GLMiranda0/Coletor-eixo/pcb/fabricacao/BOM_Coletor-Eixo_v0.2.csv

No. | Quantity | Comment | Designator | Footprint | Value | Manufacturer Part | Manufacturer | Supplier Part | Supplier
1 | 2 | 22uF | C1,C2 | C0805 | 22uF | CL21A226MAQNNNE | SAMSUNG(三星) | C45783 | LCSC
2 | 6 | 100nF | C3,C5,C7,C12,C16,C17 | C0603 | 100nF | CC0603KRX7R9BB104 | YAGEO(国巨) | C14663 | LCSC
3 | 5 | 10uF | C4,C8,C13,C14,C15 | C0603 | 10uF | CL10A106KP8NNNC | SAMSUNG(三星) | C19702 | LCSC
4 | 1 | 1uF | C6 | C0603 | 1uF | CL10A105KB8NNNC | SAMSUNG(三星) | C15849 | LCSC
5 | 3 | 10nF | C9,C10,C11 | C0603 | 10nF | 0603B103K500NT | FH(风华) | C57112 | LCSC
6 | 1 | SS14 | D1 | SMA_L4.2-W2.6-LS5.0-RD_1 |  | SS14 | MDD(辰达半导体) | C2480 | LCSC
7 | 1 | BSMD1206-050-16V | F1 | F1206 |  | BSMD1206-050-16V | BHFUSE(佰宏) | C883124 | LCSC
8 | 1 | TYPE-C 16PIN 2MD(073) | J1 | USB-C-SMD_TYPE-C-16PIN-2MD-073 |  | TYPE-C 16PIN 2MD(073) | SHOU HAN(首韩) | C2765186 | LCSC
9 | 3 | PJ-3240-5A | J2,J3,J4 | AUDIO-TH_PJ-3240-5A |  | PJ-3240-5A | 韩国韩荣 | C145814 | LCSC
10 | 1 | KF2EDGR-3.81-5P | J5 | CONN-TH_5P-P3.81_KF2EDGR-3.81-5P |  | KF2EDGR-3.81-5P | KEFA(科发) | C441185 | LCSC
11 | 1 | B2B-PH-K-S(LF)(SN) | J6 | CONN-TH_B2B-PH-K-S |  | B2B-PH-K-S(LF)(SN) | JST | C131337 | LCSC
12 | 1 | 19-217/BHC-ZL1M2RY/3T | LED1 | LED0603-FD_BLUE |  | 19-217/BHC-ZL1M2RY/3T | EVERLIGHT(亿光) | C72041 | LCSC
13 | 1 | KT-0603R | LED2 | LED-SMD_L1.6-W0.8-R-RD |  | KT-0603R | KENTO | C2286 | LCSC
14 | 1 | 19-217/GHC-YR1S2/3T | LED3 | LED0603-RD |  | 19-217/GHC-YR1S2/3T | EVERLIGHT(亿光) | C72043 | LCSC
15 | 2 | MMBT3904(RANGE:100-300) | Q1,Q2 | SOT-23-3_L2.9-W1.3-P1.90-LS2.4-BR |  | MMBT3904(RANGE:100-300) | CJ(江苏长电/长晶) | C20526 | LCSC
16 | 1 | AO3401A | Q3 | SOT-23_L2.9-W1.3-P1.90-LS2.4-BR |  | AO3401A | AOS | C15127 | LCSC
17 | 2 | 5.1kΩ | R1,R2 | R0603 | 5.1kΩ | 0603WAF5101T5E | UNI-ROYAL(厚声) | C23186 | LCSC
18 | 6 | 10kΩ | R3,R4,R5,R6,R8,R9 | R0603 | 10kΩ | 0603WAF1002T5E | UNI-ROYAL(厚声) | C25804 | LCSC
19 | 7 | 1kΩ | R7,R10,R11,R12,R17,R19,R20 | R0603 | 1kΩ | 0603WAF1001T5E | UNI-ROYAL(厚声) | C21190 | LCSC
20 | 3 | 4.7kΩ | R13,R14,R15 | R0603 | 4.7kΩ | 0603WAF4701T5E | UNI-ROYAL(厚声) | C23162 | LCSC
21 | 1 | 100Ω | R16 | R0603 | 100Ω | 0603WAF1000T5E | UNI-ROYAL(厚声) | C22775 | LCSC
22 | 1 | 2.4kΩ | R18 | R0603 | 2.4kΩ | 0603WAF2401T5E | UNI-ROYAL(厚声) | C22940 | LCSC
23 | 3 | 100kΩ | R21,R22,R24 | R0603 | 100kΩ | 0603WAF1003T5E | UNI-ROYAL(厚声) | C25803 | LCSC
24 | 1 | 68kΩ | R23 | R0603 | 68kΩ | 0603WAF6802T5E | UNI-ROYAL(厚声) | C23231 | LCSC
25 | 2 | TS-1187A-B-A-B | SW1,SW2 | SW-SMD_4P-L5.1-W5.1-P3.70-LS6.5-TL_H1.5 |  | TS-1187A-B-A-B | XKB Connection(中国星坤) | C318884 | LCSC
26 | 1 | MSK12C02 | SW3 | SW-TH_MSK12C02 |  | MSK12C02 | SHOU HAN(首韩) | C431540 | LCSC
27 | 1 | 2.4GHz | U1 | WIFI-SMD_ESP32-WROOM-32E | 2.4GHz | ESP32-WROOM-32E-N4 | ESPRESSIF(乐鑫) | C701341 | LCSC
28 | 1 | CH340C | U2 | SOP-16_L10.0-W3.9-P1.27-LS6.0-BL |  | CH340C | WCH(南京沁恒) | C84681 | LCSC
29 | 1 | AP2112K-3.3TRG1 | U3 | SOT-25-5_L2.9-W1.6-P0.95-LS2.8-BL |  | AP2112K-3.3TRG1 | DIODES(美台) | C51118 | LCSC
30 | 1 | USBLC6-2SC6 | U4 | SOT-23-6_L2.9-W1.6-P0.95-LS2.8-BL |  | USBLC6-2SC6 | ST(意法半导体) | C7519 | LCSC
31 | 1 | DW01A | U5 | SOT-23-6_L2.9-W1.6-P0.95-LS2.8-BL |  | DW01A | PUOLOP(迪浦) | C351410 | LCSC
32 | 1 | FS8205 | U6 | SOT-23-6_L2.9-W1.6-P0.95-LS2.8-BR |  | FS8205 | FORTUNE(富晶) | C32254 | LCSC
33 | 1 | TP4056-42-ESOP8 | U7 | ESOP-8_L4.9-W3.9-P1.27-LS6.0-BL-EP |  | TP4056-42-ESOP8 | TOPPOWER(南京拓微) | C16581 | LCSC
