GLMiranda0/Coletor-eixo/case/out/principal/unidade_principal_montagem.step

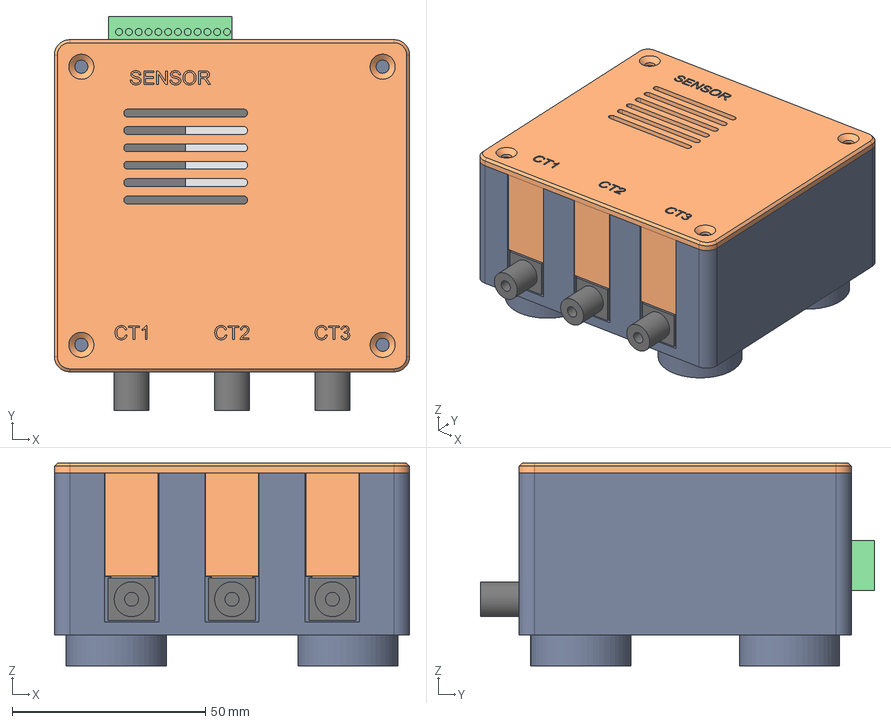
[picture p3: CAD file, 2026-11-05, last stored version]
case/out/principal/unidade_principal_montagem.step
92.0 x 102.0 x 52.5 mm
caixa_0
tampa_1
presilha_1_2
presilha_2_3
ima_4
ima_5
ima_6
ima_7
protoboard_8
esp32_pcb_9
esp32_modulo_10
usb_c_11
borneira_principal_12
p2_adaptador_13
p2_borne_14
p2_adaptador_15
p2_borne_16
p2_adaptador_17
p2_borne_18
