GLMiranda0/Coletor-eixo/case/out/sensor/base_metalica.step

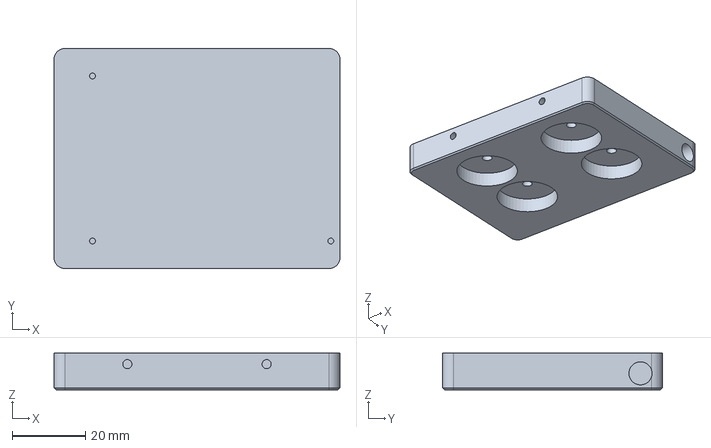
[picture p4: CAD file, 2026-11-05, last stored version]
case/out/sensor/base_metalica.step
78.0 x 60.0 x 10.0 mm
