GLMiranda0/Coletor-eixo/case/out/principal/caixa.stl

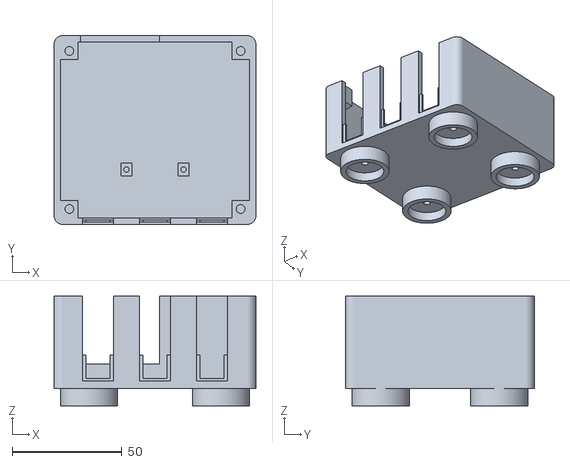
[picture p5: CAD file, 2026-11-05, last stored version]
case/out/principal/caixa.stl
92.0 x 86.0 x 50.0
