GLMiranda0/Coletor-eixo/case/out/sensor/capa.stl

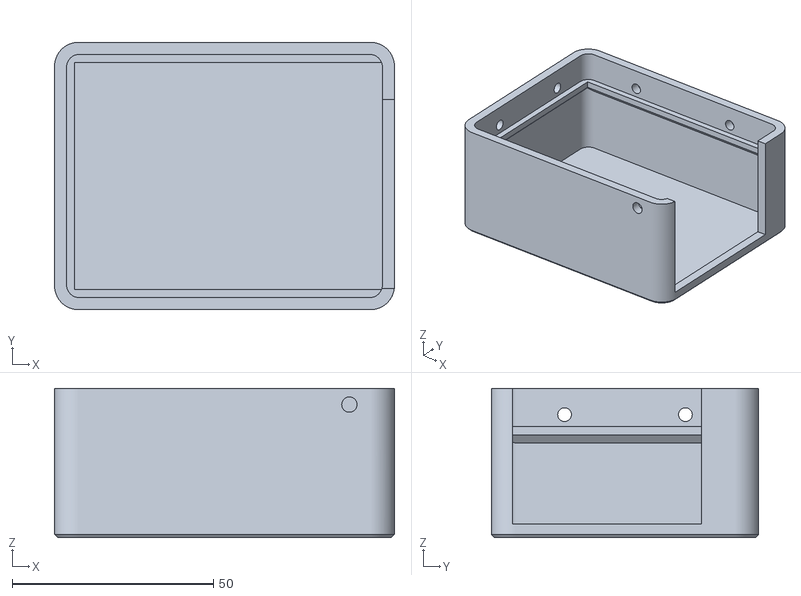
[picture p6: CAD file, 2026-11-05, last stored version]
case/out/sensor/capa.stl
84.4 x 66.4 x 37.0
