GLMiranda0/Coletor-eixo/case/out/principal/presilha.stl

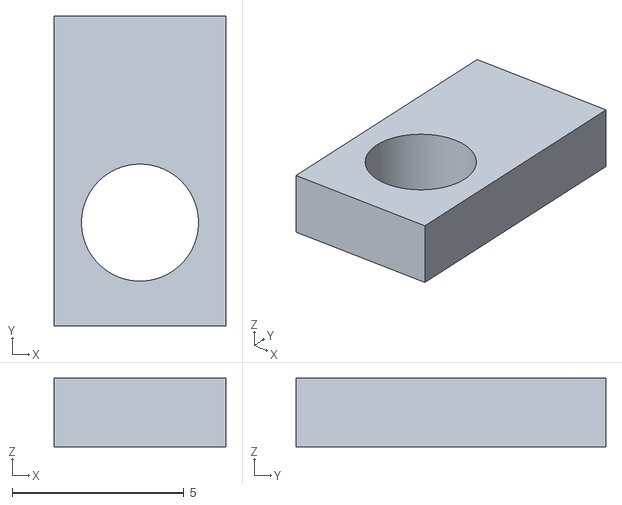
[picture p7: CAD file, 2026-11-05, last stored version]
case/out/principal/presilha.stl
5.00 x 9.00 x 2.00
