GLMiranda0/Coletor-eixo/case/out/sensor/unidade_sensor_montagem.step

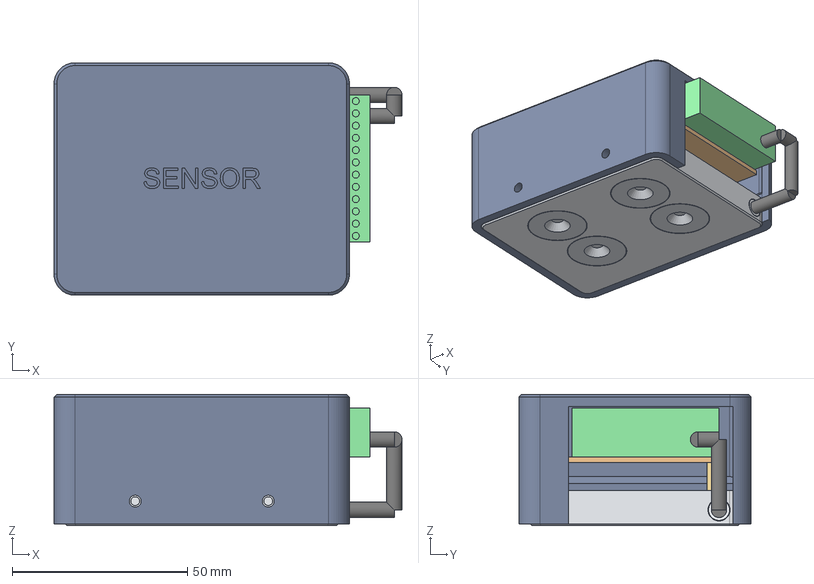
[picture p8: CAD file, 2026-11-05, last stored version]
case/out/sensor/unidade_sensor_montagem.step
99.4 x 66.4 x 37.5 mm
base_metalica_0
capa_1
ima_2
ima_3
ima_4
ima_5
sonda_inox_6
cabo_sonda_7
espacador_8
espacador_9
espacador_10
perfurada_11
gy291_12
adxl345_13
borneira_perfurada_14
