GLMiranda0/Coletor-eixo/case/out/principal/tampa.stl

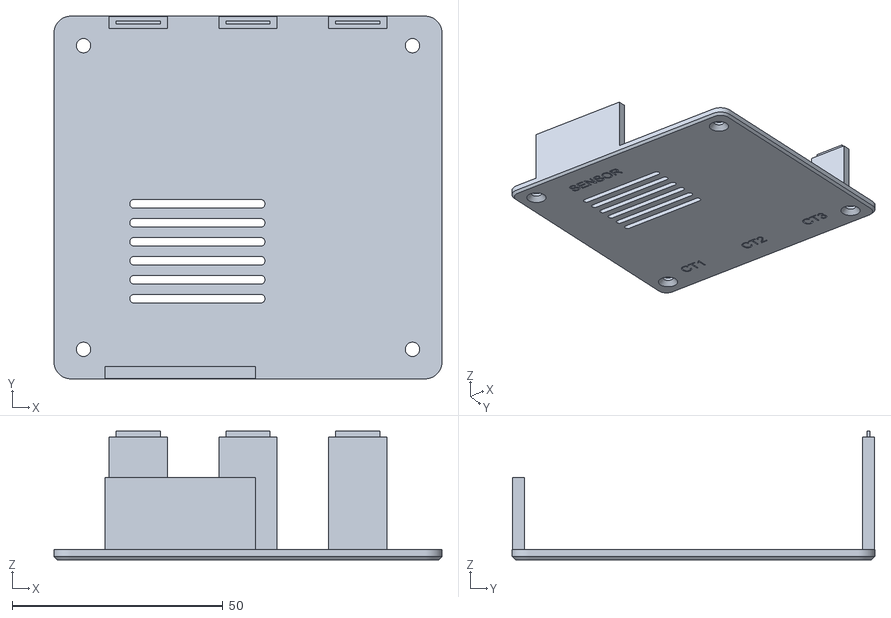
[picture p9: CAD file, 2026-11-05, last stored version]
case/out/principal/tampa.stl
92.0 x 86.0 x 30.6
