GLMiranda0/Coletor-eixo/(commit log)

2026-11-05 Coletor Eixo: firmware ESP32 e cases do protótipo
    Firmware PlatformIO (DS18B20, 3x SCT-013, ADXL345, WiFiManager, interface
    web local e envio HTTP(S)) e cases paramétricos em CadQuery. Complementa a
    plataforma em GLMiranda0/eixo-tcc.
    [base_metalica.step, caixa.stl, capa.stl, presilha.stl, tampa.stl, unidade_principal_montagem.step, unidade_sensor_montagem.step]
2026-11-05 Envio no formato do ingest do Eixo e vibração em mm/s
    - POST passa a chamar ingest(p_token, p) do eixo-tcc: {"p_token", "p": {ts,
    temp, corr, vib}} com o header apikey (chave publicável do Supabase).
    - temp = maior DS18B20 válido; corr = média das fases com leitura;
    vib = velocidade RMS (mm/s) do eixo mais alto, integrada da aceleração
    do ADXL345 com passa-altas de 5 Hz (escala da ISO 10816 que o Eixo usa).
    - Chave publicável configurável no portal, na interface local e na API.
    - Interface local mostra a velocidade por eixo; README atualizado.
2026-11-05 Remove os cases do repositório
    A montagem de fixação está sendo refeita à mão e volta depois. Os arquivos
    continuam na máquina local, agora ignorados pelo git.
    [base_metalica.step, caixa.stl, capa.stl, presilha.stl, tampa.stl, unidade_principal_montagem.step, unidade_sensor_montagem.step]
2026-11-05 Interface local com a identidade visual do Eixo
    - Tokens, fontes (Sora / IBM Plex), cards, botões, pills e gauges iguais aos
    de GLMiranda0/eixo-tcc (app/src/styles.css), com tema claro, escuro e auto.
    - "Tempo real" mostra temp, corr e vib exatamente como vão para o ingest,
    com a zona ISO 10816-3 de referência (grupo 2, base rígida).
    - /api/readings ganha o objeto "eixo"; o POST e a tela usam a mesma conta
    (addEixoValues).
    - Fontes do Google sem bloquear a página; offline cai nas do sistema.
2026-11-05 Vibração: Butterworth de 2ª ordem em 10 Hz e integrador de Al-Alaoui
    - Passa-altas de 1ª ordem em 5 Hz trocado por Butterworth de 2ª ordem em
    10 Hz (bilinear com pré-distorção), o limite de baixo da ISO 10816.
    - Soma simples trocada pelo integrador de Al-Alaoui: a soma superestimava
    as frequências altas (+32% em 200 Hz); agora fica em +3%.
    - Simulado com senoides: 0,99 de 29,5 a 100 Hz, 1,03 em 200 Hz,
    ruído de ~0,13 mm/s (antes 0,20).
2026-11-05 Firmware 1.1.0: fila local e envio em lote com idempotência
    - Cada ciclo (2 s) entra numa fila de 90 leituras; POST de até 30 por lote,
    removidas da fila só após 2xx; fila cheia descarta a mais antiga e conta a perda
    - Cada leitura leva device_id, boot (contador em flash) e seq; sem NTP vai idade_ms
    - Conexão TLS persistente (keep-alive) com nova tentativa se a conexão caiu
    - Token do dispositivo não aparece mais na interface local nem no portal
    - Status mostra fila, perdas, boot, seq e versão do firmware
    - Exige a migração 003 do eixo-tcc aplicada no banco antes de gravar
2026-11-07 PCB v0.1: placa principal com ESP32-WROOM-32E soldado (proposta)
    Esquemático e PCB no EasyEDA Pro com os mesmos GPIOs do protótipo:
    USB-C + CH340C com auto-reset, AMS1117-3.3, 3 entradas P2 para os
    SCT-013 com polarização de 1,65 V, borneira de 5 vias para DS18B20 e
    ADXL345. Placa de 80 x 60 mm, 2 camadas, DRC sem erros. Inclui Gerber,
    BOM e Pick & Place no formato da JLCPCB; o modelo 3D (STEP) fica fora
    do repositório.
    [BOM_Coletor-Eixo_v0.1.csv, PickAndPlace_Coletor-Eixo_v0.1.csv]
2026-11-07 PCB: README indica como gerar o modelo 3D fora do repositório
2026-11-09 PCB v0.2 (proposta): bateria Li-ion, contorno 80x60 e desenho técnico
    Proposta de próximo passo do protótipo; não será fabricada. O projeto segue
    com o DevKit + protoboard atual.
    - Bateria Li-ion de 1 célula no J6 (JST-PH), carga pela USB-C (TP4056,
    500 mA), proteção DW01A + FS8205A, troca automática USB/bateria e chave
    liga/desliga; regulador trocado por AP2112K-3.3.
    - Leituras de bateria (GPIO33) e USB presente (GPIO17); sensores nos mesmos
    GPIOs do protótipo.
    - Contorno fechado em 80,0 x 60,0 mm, P2 0,7 mm além da borda, ESP32 rente
    à borda; DRC sem erros, 43 redes conferidas pad a pad.
    - Esquemático em A2 com fios coloridos, carimbo do Eixo e notas.
    - Desenho técni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
    [BOM_Coletor-Eixo_v0.1.csv, BOM_Coletor-Eixo_v0.2.csv, PickAndPlace_Coletor-Eixo_v0.1.csv, PickAndPlace_Coletor-Eixo_v0.2.csv]
2026-11-14 Firmware 1.1.1: vibração não some da interface durante a coleta
    measureVibration gravava direto em last.vib, que ficava com valid = false
    durante a janela de ~1 s em que a interface web continua sendo atendida.
    As consultas a /api/readings nesse intervalo vinham sem "vib" e a tela
    alternava para "sem leitura". Agora a medição usa uma cópia local e só
    substitui last.vib no fim. Serial e POST não eram afetados.
